HexabitzPlatform/H1FR6x-Hardware/README.md

# H1FR6x-Hardware

Hexabitz TESEO-LIV4F GNSS Module Hardware Design

Redesign using the STM32G0B1CEU6 MCU and Teseo-LIV4F. Review the previous design for errors and correct them. Use the X-NUCLEO-LIV4A1 design as a reference.

This design must use two hexagons with a 4-layer PCB stack-up.
