HexabitzPlatform/H1FR6x-Hardware/old design/Documentation/H1FR50.pdf

PA4 20 | PA5 21 | PA6 22 | PA7 23 | PC4 24 | PC5 25
PB0 | 26 PB1 | 27 PB2 | 28 PB10 | 29 PC14-OSC32_IN(PC14) 3

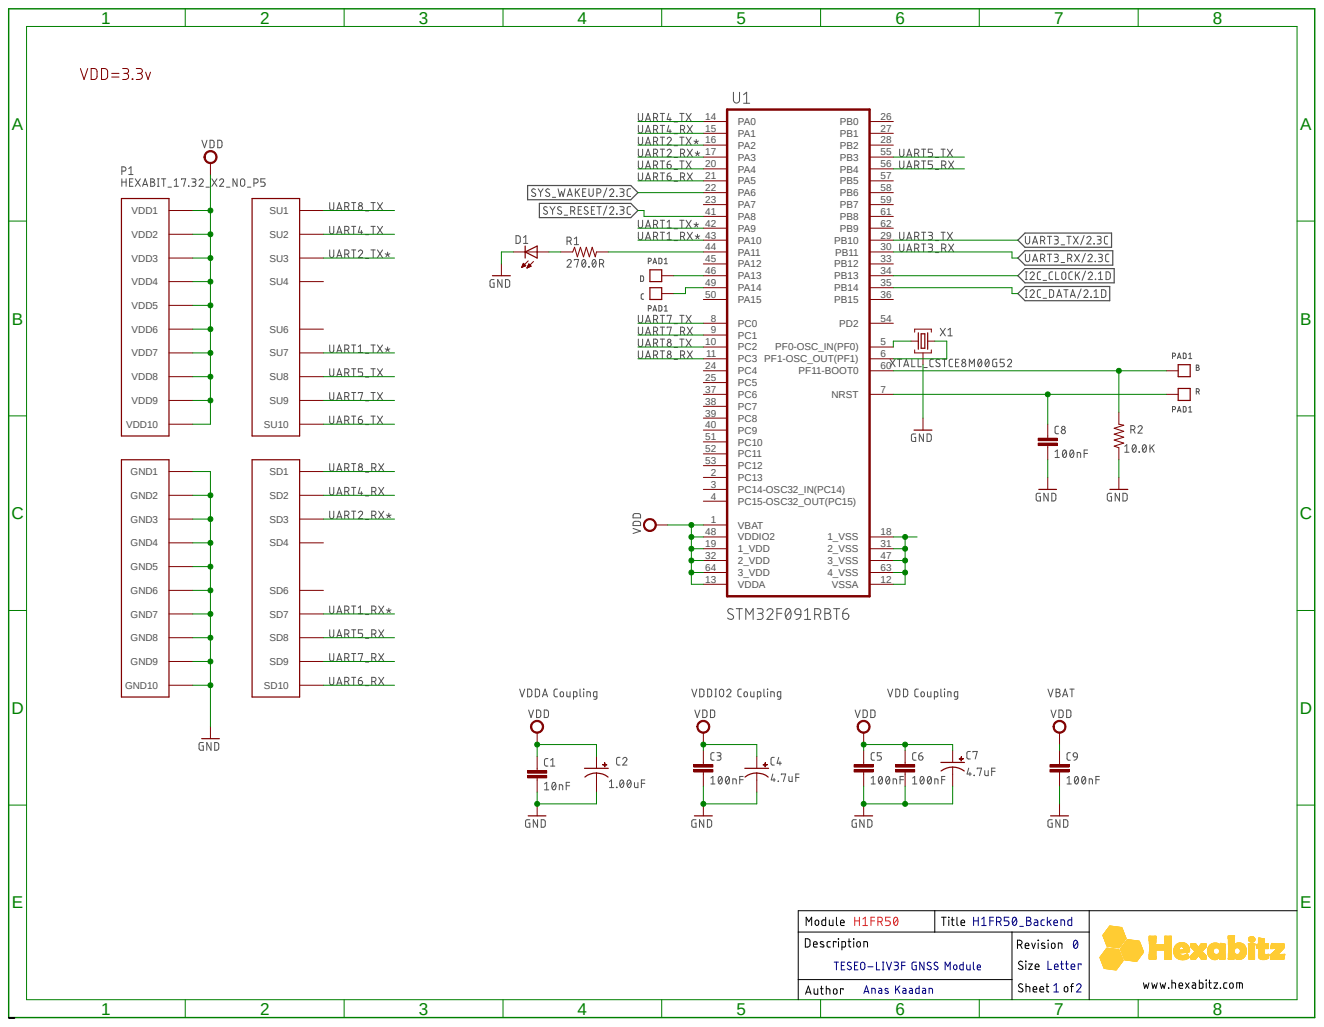
[picture p1: page 1]
PC15-OSC32_OUT(PC15) 4; PF0-OSC_IN(PF0); 59 PF1-OSC_OUT(PF1); 6 PF11-BOOT0; 62 NRST; VBAT 1; VSSA; 12 VDDA 13; 1_VSS; 1_VDD 19; 2_VSS; 2_VDD 32; 3_VSS; 47 VDDIO2 48; 4_VSS; 63 3_VDD 64; VDD2 VDD3 VDD4 VDD5 VDD6 GND2 GND3 GND4 GND5 GND6; VDD7 VDD8 VDD9 GND7 GND8 GND9; VDD1 VDD10 GND1 GND10; SU10 ABCDE; ABCDE 1

A

A

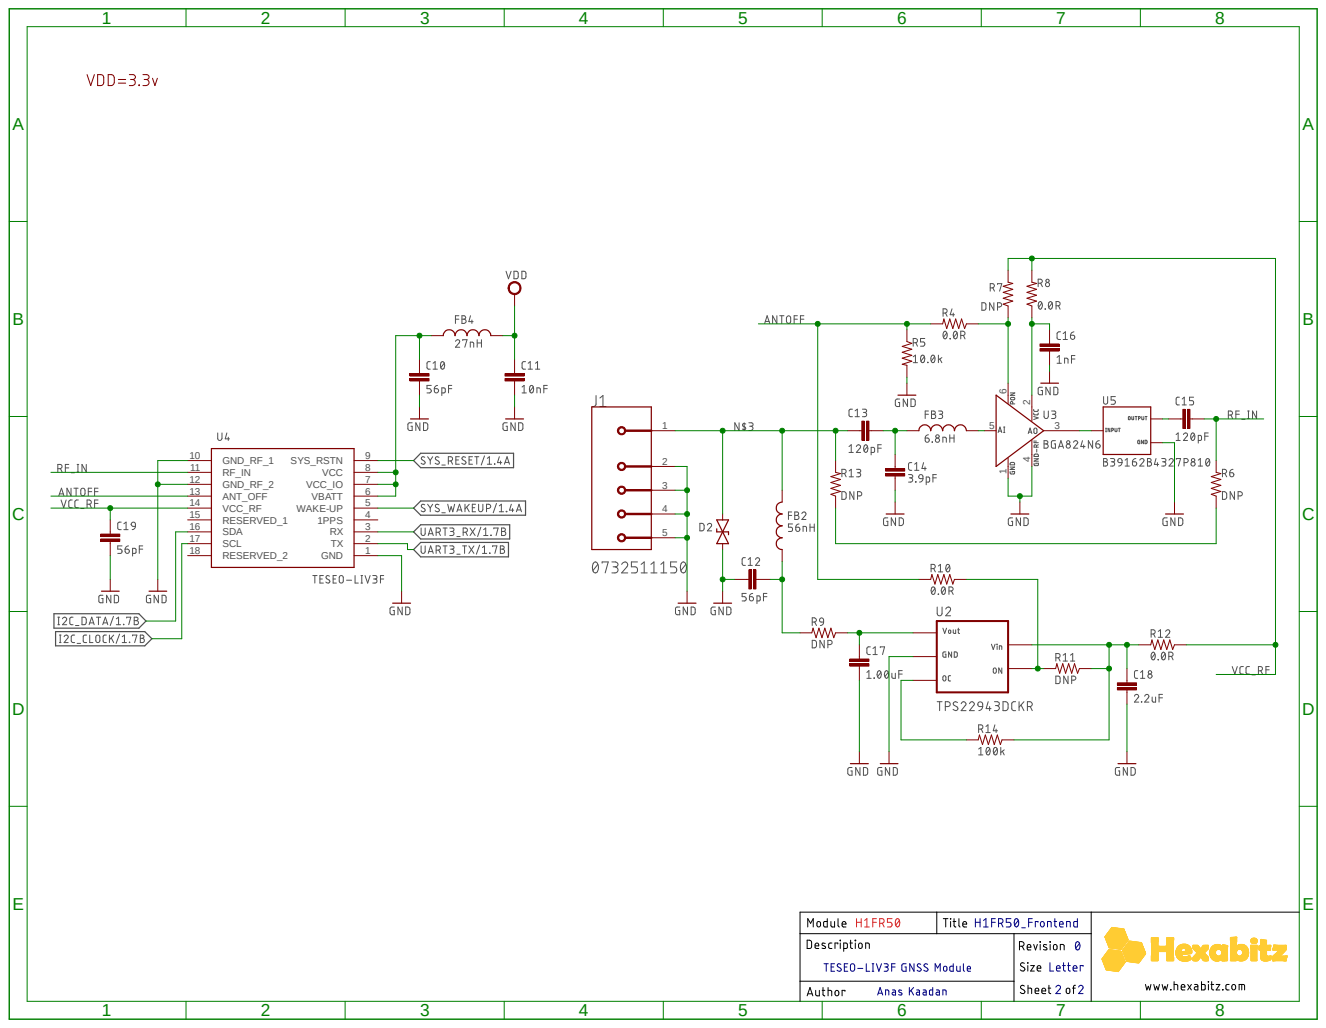
[picture p2: page 2]
GND; 1PPS; 4 WAKE-UP; 5 VBATT; 6 VCC_IO; 7 VCC; 8 SYS_RSTN; 9 RESERVED_2 18; SCL 17; SDA 16; RESERVED_1 15; VCC_RF 14; ANT_OFF 13; GND_RF_2 12; GND_RF_1 10
