HexabitzPlatform/H1FR6x-Hardware/(list of files, drawings)

Other design files:
Design/H01R0.PcbDoc
Design/H01R0.PrjPcb
Design/H01R0_Backend.SchDoc
Design/H01R0_Frontend 1.SchDoc
Design/H01R0_Frontend 2.SchDoc
