HexabitzPlatform/H1FR6x-Hardware/old design/Design/H1FR50.brd

## EAGLE design old design/Design/H1FR50.brd (2025-10-16, an earlier design)

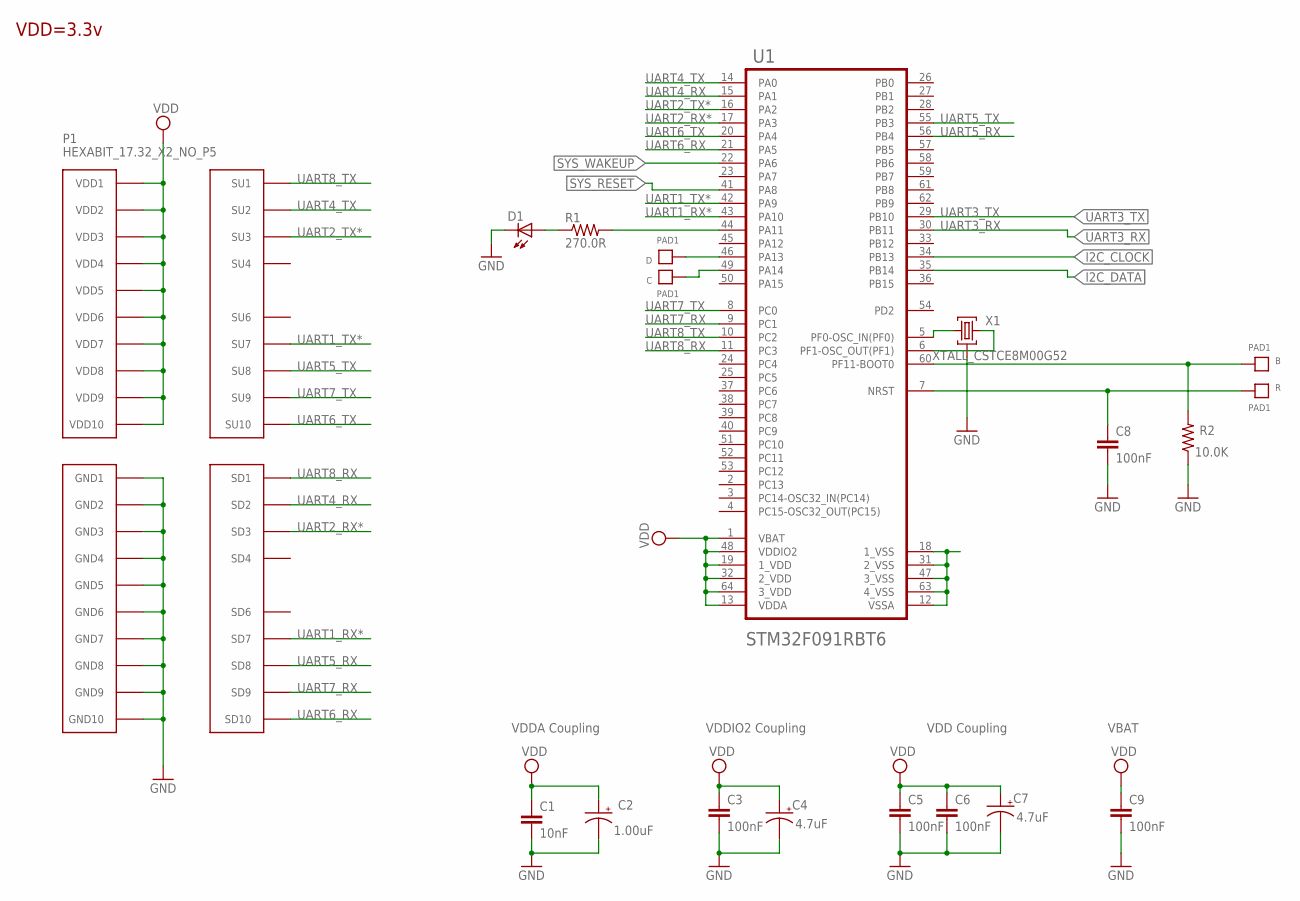
[picture p3: schematic H1FR50.sch, sheet 1]

Parts:
B: PAD1
C: PAD1
C1: 10nF; C-0603; TOLERANCE 10%; VOLTAGE_RATING 50V; MPN C0603C103K5RACTU
C2: 1.00uF; C-0805-POL; TOLERANCE 10%; VOLTAGE_RATING 16V; MPN CC0805KKX7R7BB105
C3, C6, C8: 100nF; C-0603; TOLERANCE 10%; VOLTAGE_RATING 10V; MPN C0603C104K8RACTU
C4, C7: 4.7uF; C-0805-POL; TOLERANCE 10%; VOLTAGE_RATING 25V; MPN GRM21BC81E475KA12L
C5: 100nF; C-0603; TOLERANCE 10%; VOLTAGE_RATING 10; MPN C0603C104K8RACTU
C9: 100nF; C-0603; TOLERANCE 10V; VOLTAGE_RATING 10%; MPN C0603C104K8RACTU
D: PAD1
D1: VLMS1300-GS08; MPN VLMS1300-GS08
P1: HEXABIT_17.32_X2_NO_P5
R: PAD1
R1: 270.0R; R-0603; TOLERANCE 1%; MPN RC0603FR-07270RL
R2: 10.0K; R-0603; TOLERANCE 5%; MPN RC0603JR-0710KL
U1: STM32F091RBT6STMICROELECTRONICS_STM32F091RBT6_0_1; STMICROELECTRONICS_STM32F091RBT6_1
X1: XTALL_CSTCE8M00G52

Connections:
B1: B.P$1, B.P$2, R2.2, U1.60 (PF11-BOOT0)
GND: C1.2, C2.2 (-), C3.2, C4.2 (-), C5.2, C6.2, C7.2 (-), C8.2, C9.2, D1.C, P1.PAD_PD11 (GND1), P1.PAD_PD12 (GND2), P1.PAD_PD13 (GND3), P1.PAD_PD14 (GND4), P1.PAD_PD15 (GND5), P1.PAD_PD16 (GND6), P1.PAD_PD17 (GND7), P1.PAD_PD18 (GND8), P1.PAD_PD19 (GND9), P1.PAD_PD20 (GND10), R2.1, U1.12 (VSSA), U1.18 (1_VSS), U1.31 (2_VSS), U1.47 (3_VSS), U1.63 (4_VSS), X1.P$2 (2); also elsewhere on the board
I2C_CLOCK: U1.34 (PB13); also elsewhere on the board
I2C_DATA: U1.35 (PB14); also elsewhere on the board
unnamed: D1.A, R1.1
unnamed: U1.5 (PF0-OSC_IN(PF0)), X1.P$1 (1)
unnamed: U1.6 (PF1-OSC_OUT(PF1)), X1.P$3 (3)
unnamed: D.P$1, D.P$2, U1.46 (PA13)
unnamed: C.P$1, C.P$2, U1.49 (PA14)
unnamed: R1.2, U1.44 (PA11)
R1: C8.1, R.P$1, R.P$2, U1.7 (NRST)
SYS_RESET: U1.41 (PA8); also elsewhere on the board
SYS_WAKEUP: U1.22 (PA6); also elsewhere on the board
UART1_RX*: P1.PAD_PD7 (SD7), U1.43 (PA10)
UART1_TX*: P1.PAD_PU7 (SU7), U1.42 (PA9)
UART2_RX*: P1.PAD_PD3 (SD3), U1.17 (PA3)
UART2_TX*: P1.PAD_PU3 (SU3), U1.16 (PA2)
UART3_RX: U1.30 (PB11); also elsewhere on the board
UART3_TX: U1.29 (PB10); also elsewhere on the board
UART4_RX: P1.PAD_PD2 (SD2), U1.15 (PA1)
UART4_TX: P1.PAD_PU2 (SU2), U1.14 (PA0)
UART5_RX: P1.PAD_PD8 (SD8), U1.56 (PB4)
UART5_TX: P1.PAD_PU8 (SU8), U1.55 (PB3)
UART6_RX: P1.PAD_PD10 (SD10), U1.21 (PA5)
UART6_TX: P1.PAD_PU10 (SU10), U1.20 (PA4)
UART7_RX: P1.PAD_PD9 (SD9), U1.9 (PC1)
UART7_TX: P1.PAD_PU9 (SU9), U1.8 (PC0)
UART8_RX: P1.PAD_PD1 (SD1), U1.11 (PC3)
UART8_TX: P1.PAD_PU1 (SU1), U1.10 (PC2)
VDD: C1.1, C2.1 (+), C3.1, C4.1 (+), C5.1, C6.1, C7.1 (+), C9.1, P1.PAD_PU11 (VDD1), P1.PAD_PU12 (VDD2), P1.PAD_PU13 (VDD3), P1.PAD_PU14 (VDD4), P1.PAD_PU15 (VDD5), P1.PAD_PU16 (VDD6), P1.PAD_PU17 (VDD7), P1.PAD_PU18 (VDD8), P1.PAD_PU19 (VDD9), P1.PAD_PU20 (VDD10), U1.1 (VBAT), U1.13 (VDDA), U1.19 (1_VDD), U1.32 (2_VDD), U1.48 (VDDIO2), U1.64 (3_VDD); also elsewhere on the board

Notes on the sheet:
VDDA Coupling
VDDIO2 Coupling
VDD Coupling
VBAT
VDD=3.3v

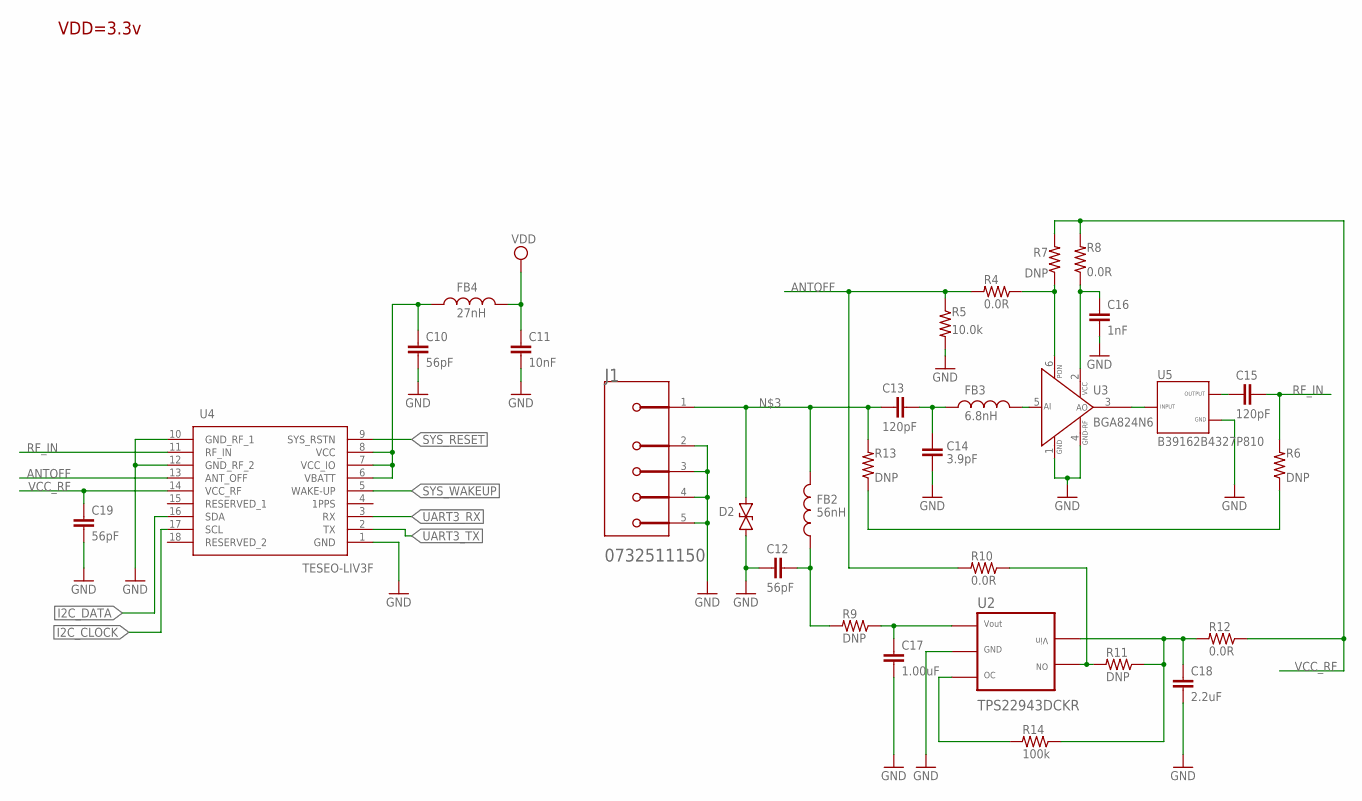
[picture p4: schematic H1FR50.sch, sheet 2]

Parts:
C10, C19: 56pF; C-0201; MPN GRM0335C1E560GA01D
C11: 10nF; C-0402; MPN CGA2B3X7R1H103K050BE
C12: 56pF; C-0402; MPN GRM1555C1H560JA01D
C13, C15: 120pF; C-0402; MPN GRM1555C1H121JA01D
C14: 3.9pF; C-0402; MPN GRM1555C1H3R9WA01D
C16: 1nF; C-0402; MPN GRM155R71H102KA01D
C17: 1.00uF; C-0402; MPN C0402C105K8PAC7411
C18: 2.2uF; C-0402; MPN C0402C225K7PACTU
D2: ESDARF02-1BU2CK; CAPC0201X13N
FB2: 56nH; FB-0402; MPN LQW15AN6N8G00D
FB3: 6.8nH; FB-0402; MPN 744784156A
FB4: 27nH; FB-0402; MPN LQG15HS27NJ02D
J1: MOLEX_INC_0732511150MOLEX_INC_0732511150_0_0; MOLEX_INC_0732511150_0
R4, R8, R10, R12: 0.0R; R-0402
R5: 10.0k; R-0402; TOLERANCE ±1%; MPN CRGCQ0402F10K
R6, R7, R9, R11, R13: DNP; R-0402
R14: 100k; R-0603; TOLERANCE ±1%; MPN AC0603FR-07100KL
U2: TPS22943DCKR; SOT65P210X110-5N
U3: BGA824N6
U4: TESEO-LIV3F; SON110P970X1010X230-18N
U5: B39162B4327P810; FIL_B39162B4327P810

Connections:
ANTOFF: R4.2, R5.1, R10.2, U4.13 (ANT_OFF)
ANT_IN: R6.1, R13.1
GND: C10.1, C11.1, C12.1, C14.1, C16.2, C17.2, C18.2, C19.1, D2.1, J1.2 (MNT_1), J1.3 (MNT_2), J1.4 (MNT_3), J1.5 (MNT_4), R5.2, U2.2 (GND), U3.1 (GND), U3.4 (GND-RF), U4.1 (GND), U4.10 (GND_RF_1), U4.12 (GND_RF_2), U5.2 (GND), U5.3 (GND), U5.5 (GND); also elsewhere on the board
I2C_CLOCK: U4.17 (SCL); also elsewhere on the board
I2C_DATA: U4.16 (SDA); also elsewhere on the board
unnamed: C13.2, C14.2, FB3.1
unnamed: R14.2, U2.3 (OC)
unnamed: C13.1, D2.2, FB2.2, J1.1, R13.2
unnamed: C12.2, FB2.1, R9.2
unnamed: FB3.2, U3.5 (AI)
unnamed: U3.3 (AO), U5.1 (INPUT)
unnamed: R4.1, R7.1, U3.6 (PON)
unnamed: C15.1, U5.4 (OUTPUT)
unnamed: C16.1, R8.1, U3.2 (VCC)
unnamed: C17.1, R9.1, U2.1 (VOUT)
unnamed: R10.1, R11.2, U2.4 (ON)
unnamed: C18.1, R11.1, R12.2, R14.1, U2.5 (VIN)
RF_IN: C15.2, R6.2, U4.11 (RF_IN)
SYS_RESET: U4.9 (SYS_RSTN); also elsewhere on the board
SYS_WAKEUP: U4.5 (WAKE-UP); also elsewhere on the board
UART3_RX: U4.3 (RX); also elsewhere on the board
UART3_TX: U4.2 (TX); also elsewhere on the board
VCC_RF: C19.2, R7.2, R8.2, R12.1, U4.14 (VCC_RF)
VCC_RF1: C10.2, FB4.1, U4.6 (VBATT), U4.7 (VCC_IO), U4.8 (VCC)
VDD: C11.2, FB4.2; also elsewhere on the board

Notes on the sheet:
VDD=3.3v

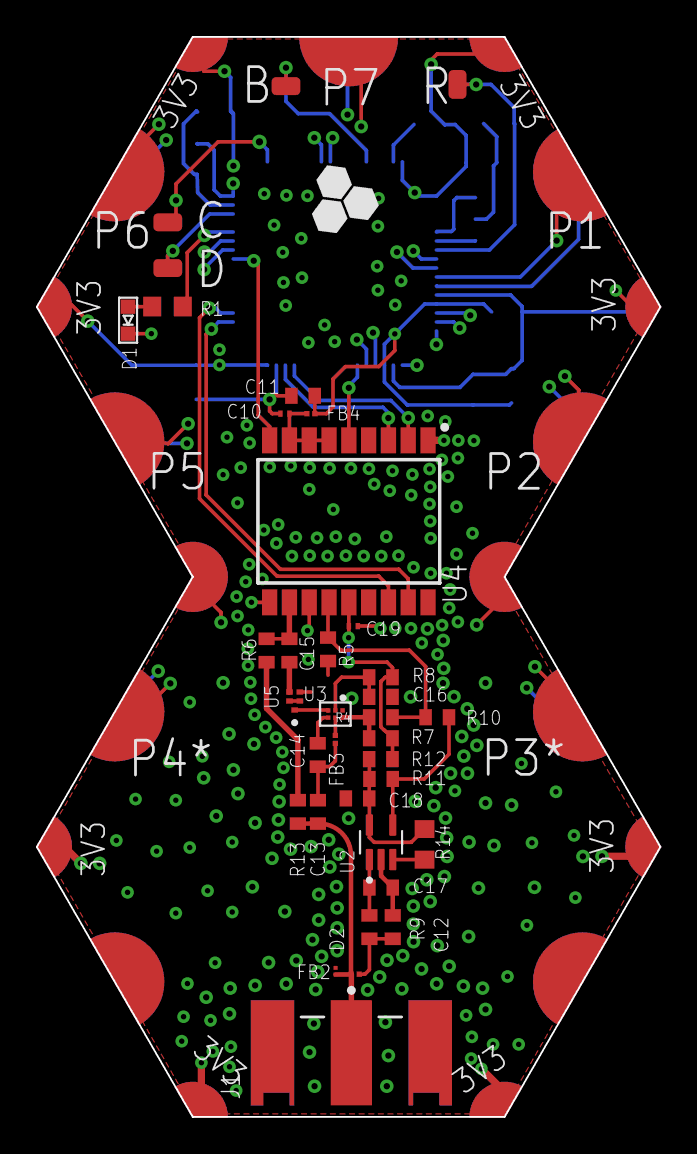
[picture p5: board H1FR50.brd from above]

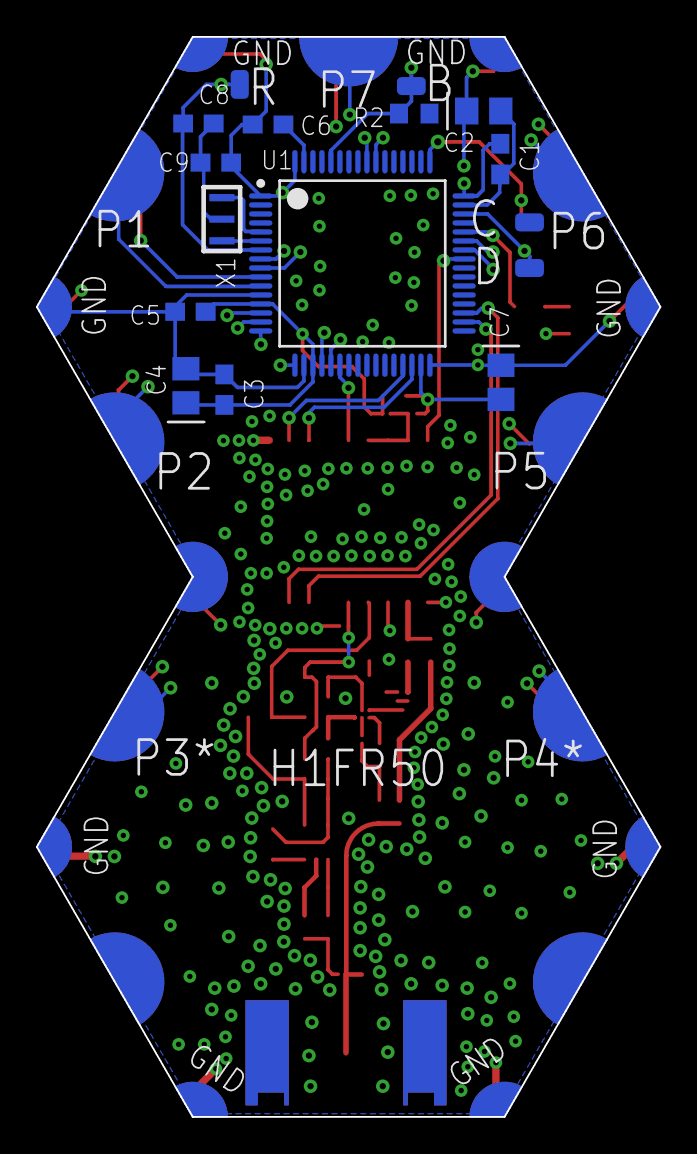
[picture p6: board H1FR50.brd from below]

Board: 4 copper layers, 34.6 x 60.0 mm, 49 parts (12 on the bottom side), 47 nets.
