HexabitzPlatform/H1FR6x-Hardware/(commit log)

2021-03-17 - Schematic - PCB - BOM - Documentation
    [H1FR50.brd, H1FR50.sch, H1FR50.xlsx]
2021-03-18 Added Keepout areas in PCB..
    [H1FR50.brd]
2021-03-19 - Rearanged all P#.. - Removed Keepout areas.. - Renamed all NM to DNP.. - Moved D1 from layer 16 to layer 1.. - Changed R8 from 0R NM to 0R.. - Placed more Grounding vias around RF connector in brd.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
    [H1FR50.brd, H1FR50.sch, H1FR50.xlsx]
2021-03-27 - Redesigned both Schematic and PCB.. - Updated BOM and Documentation..
    [H1FR50.brd, H1FR50.sch, H1FR50.xlsx]
2021-04-03 - Changed Polygen for layer 1 to GND - Wrote board specification on documentation layer
    [H1FR50.brd, H1FR50.sch]
2021-04-05 Removed all Blined Vias..
    [H1FR50.brd]
2021-04-05 - Changed RF Connector.. - Documents and BOM were updated..
    [H1FR50.brd, H1FR50.sch, H1FR50.xlsx]
2021-04-07 - Changed the RF route width to 10 mil
    [H1FR50.brd]
2021-04-07 - Fixed some DRC errors.. - Changed TOP layer (1) polygon isolation to 7 mill
    [H1FR50.brd]
2021-04-17 - reconnected side pads to power..
    [H1FR50.xlsx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]
2021-04-21 Updated BOM..
    [H1FR50.xlsx]
2021-04-22 - Updated BOM..
    [H1FR50.xlsx]
2022-09-12 -Changing the MC to STM32G0B1CEU6N -Changing the GPS Module to SAM-M8Q-0-10 u-blox
    [H1FR50.brd, H1FR50.sch, H1FR50.xlsx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]
2022-09-24 -Changing the layout design to improve the performance
    [H1FR50.brd, H1FR50.xlsx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]
2023-02-13 -Correcting some documentaion issues
    [H1FR50.brd, H1FR50.sch, H1FR50.xlsx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]
2025-10-16 The Altium template has been added.
    [H01R0.PcbDoc, H01R0.PrjPcb, H01R0_Backend.SchDoc, H01R0_Frontend 1.SchDoc, H01R0_Frontend 2.SchDoc, H1DR1x-T.xlsx, H1FR50.brd, H1FR50.sch]
